envergokaycay/3-phase-bldc-motor-driver/images/2D_Bottom_Layer_Polygon.jpg

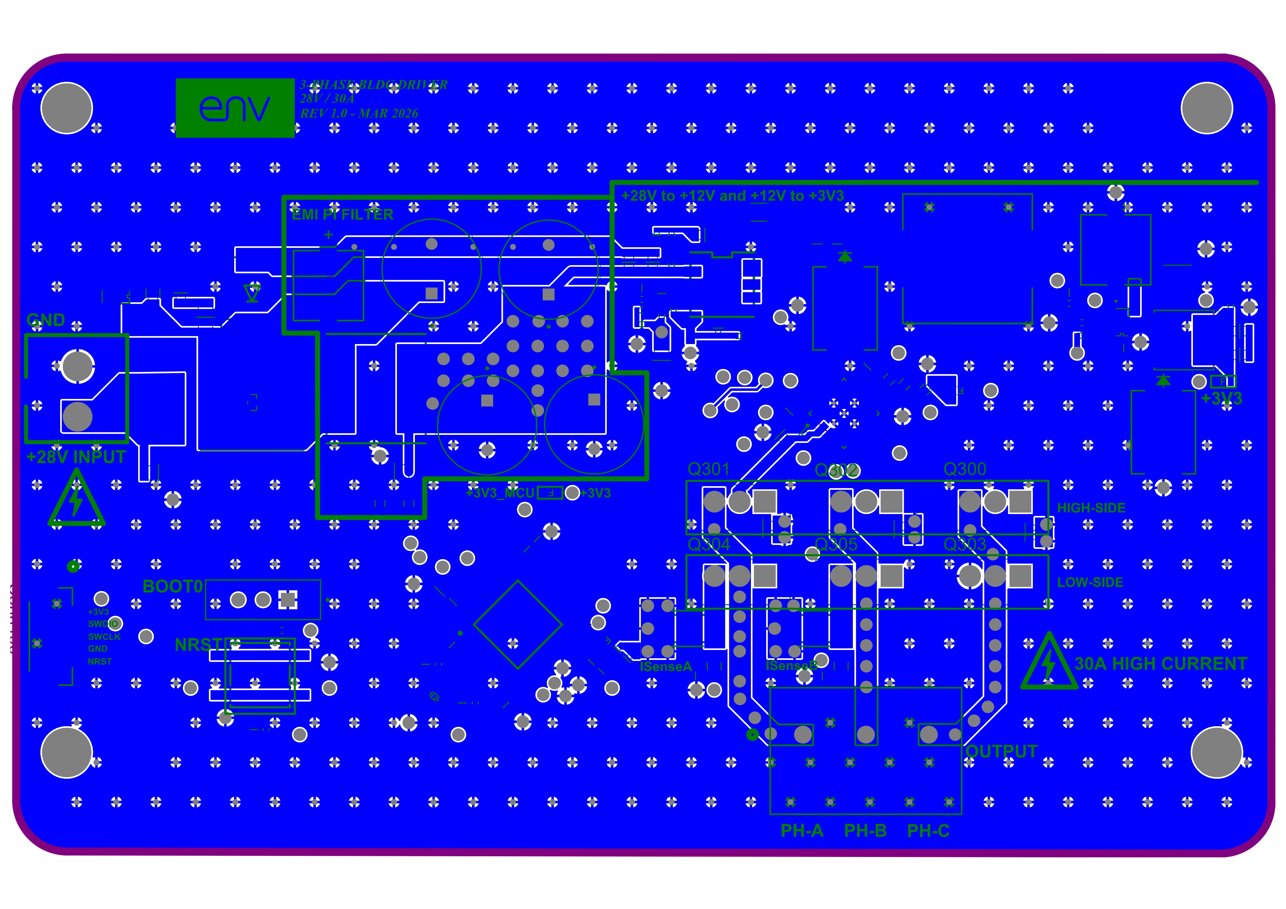
images/2D_Bottom_Layer_Polygon.jpg
