envergokaycay/3-phase-bldc-motor-driver/images/2D_Top_Layer.jpg

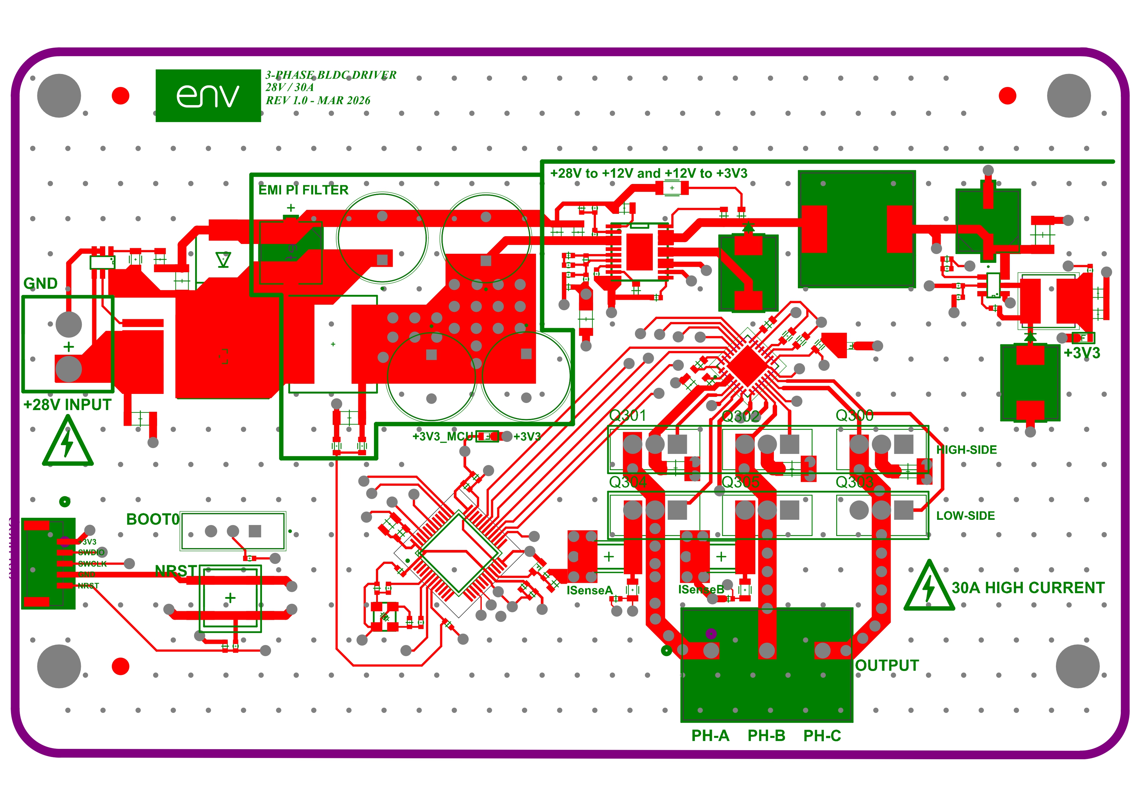
images/2D_Top_Layer.jpg
