envergokaycay/3-phase-bldc-motor-driver/images/mechanical.jpg

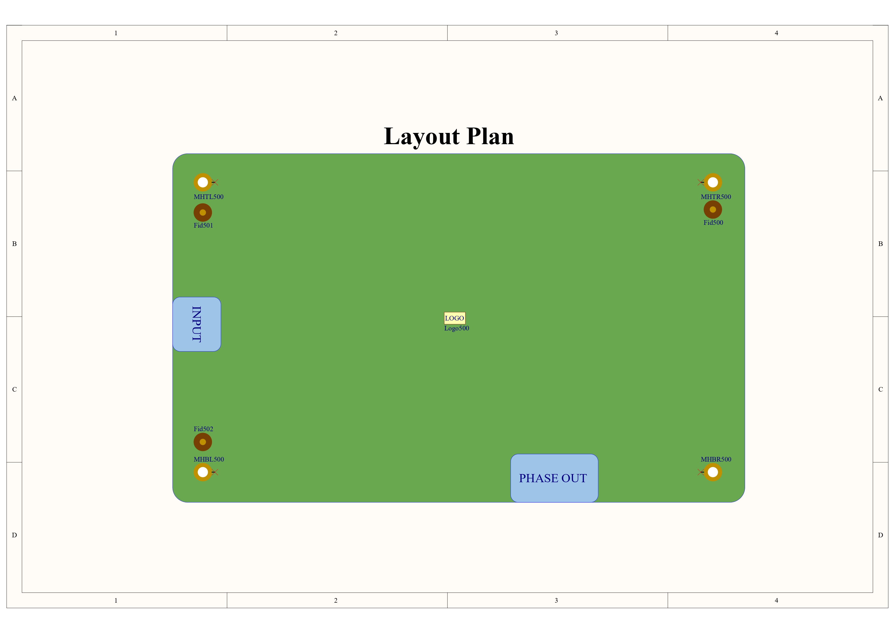
images/mechanical.jpg
