envergokaycay/3-phase-bldc-motor-driver/images/PCB_Bottom.png

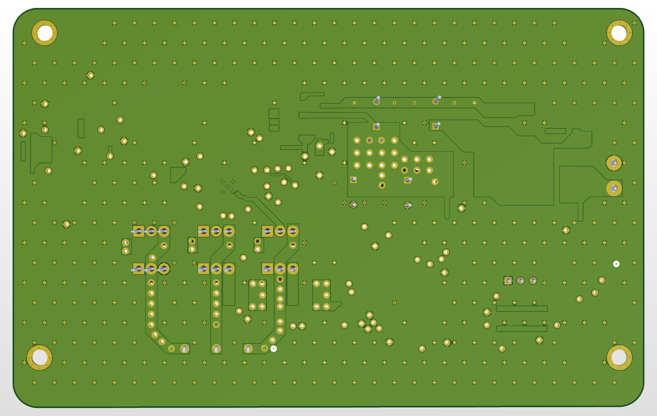
images/PCB_Bottom.png
