envergokaycay/3-phase-bldc-motor-driver/(list of files, drawings)

Other design files:
3_Phase_BLDC.PrjPcb
Schematics/Inverter_Power_Stage.SchDoc
Schematics/Main.SchDoc
Schematics/MCU_Control.SchDoc
Schematics/Mechanical.SchDoc
Schematics/Power_Distribution.SchDoc
Schematics/Power_Protection.SchDoc
